NatLabRockies/MODAQ-BB/README.md

# MODAQ Black Box Code and Documentation. 

MODAQ-BB documentation is available here: https://nrel.github.io/MODAQ-BB/

Known Issues:
1. Incremental rebooting approximately every 2 hours 
2. Occasional duplicate satellite messages 

NREL Software Record number: SWR-24-72 “MODAQ BlackBox"
