NatLabRockies/MODAQ-BB/docs/docs/img/CAD_Ant_Shelf_Assemb.png

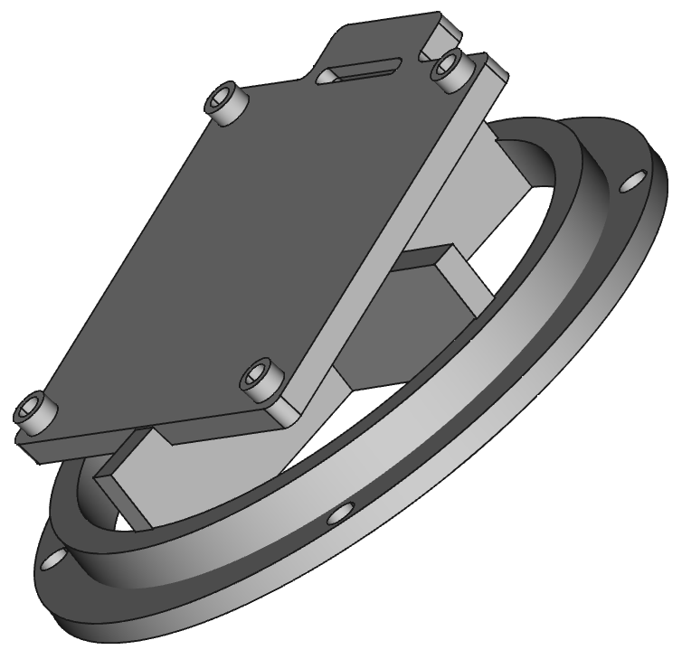
docs/docs/img/CAD_Ant_Shelf_Assemb.png
