NatLabRockies/MODAQ-BB/docs/docs/img/CAD_Complete.png

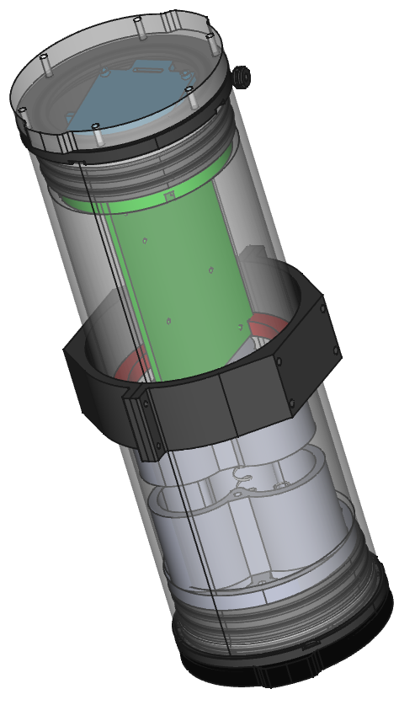
docs/docs/img/CAD_Complete.png
