NatLabRockies/MODAQ-BB/docs/docs/img/CAD_Elect_Shelf_Assemb.png

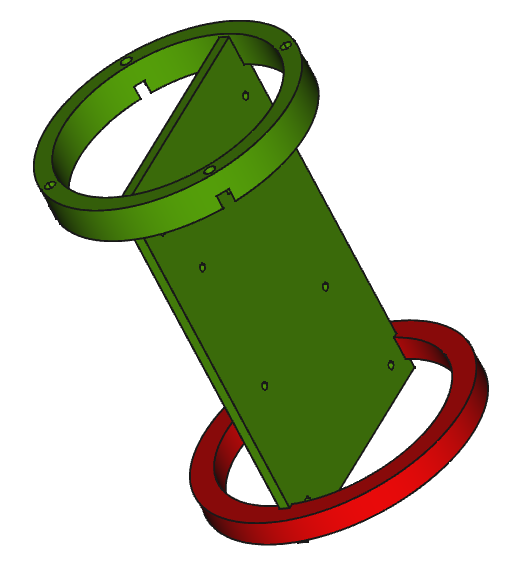
docs/docs/img/CAD_Elect_Shelf_Assemb.png
