NatLabRockies/MODAQ-BB/docs/docs/assets/Electronics_Shelf_Assembly.stl

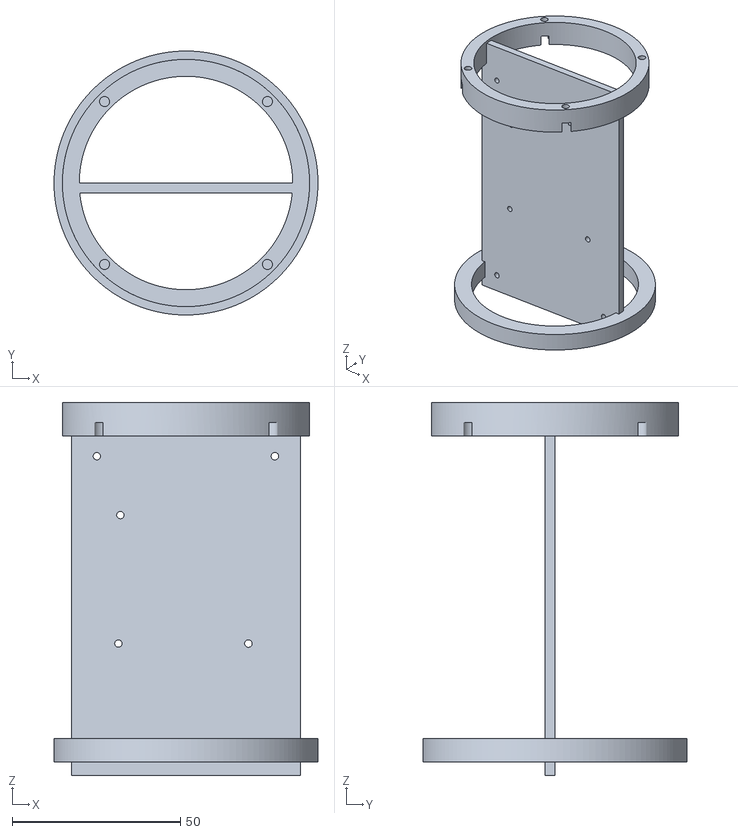
[picture p12: CAD file, 2025-12-03]
docs/docs/assets/Electronics_Shelf_Assembly.stl
78.6 x 78.6 x 111.0
