NatLabRockies/MODAQ-BB/docs/docs/assets/Antenna_Shelf_Assembly.stl

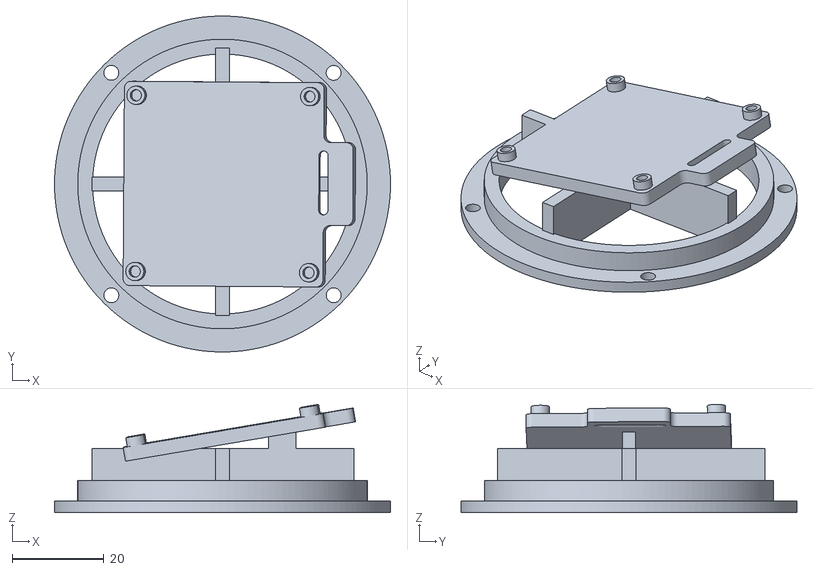
[picture p13: CAD file, 2025-12-03]
docs/docs/assets/Antenna_Shelf_Assembly.stl
73.3 x 73.3 x 23.6
