NatLabRockies/MODAQ-BB/src/LIS3MDL_runtime.h

// Ensure lis3mdl is declared and initialized before using this function
void printOperatingMode() {
  Serial.print("Operation mode set to: ");
  int mode = lis3mdl.getOperationMode();
  switch (mode) {
    case LIS3MDL_CONTINUOUSMODE: Serial.println("Continuous"); break;
    case LIS3MDL_SINGLEMODE: Serial.println("Single mode"); break;
    case LIS3MDL_POWERDOWNMODE: Serial.println("Power-down"); break;
    default: Serial.println("Unknown mode"); break;
  }
}

void printPerformanceMode() {
  Serial.print("Performance mode set to: ");
  switch (lis3mdl.getPerformanceMode()) {
    case LIS3MDL_LOWPOWERMODE: Serial.println("Low"); break;
    case LIS3MDL_MEDIUMMODE: Serial.println("Medium"); break;
    case LIS3MDL_HIGHMODE: Serial.println("High"); break;
    case LIS3MDL_ULTRAHIGHMODE: Serial.println("Ultra-High"); break;
  }
}

void printDataRate() {
  Serial.print("Data rate set to: ");
  switch (lis3mdl.getDataRate()) {
    case LIS3MDL_DATARATE_0_625_HZ: Serial.println("0.625 Hz"); break;
    case LIS3MDL_DATARATE_1_25_HZ: Serial.println("1.25 Hz"); break;
    case LIS3MDL_DATARATE_2_5_HZ: Serial.println("2.5 Hz"); break;
    case LIS3MDL_DATARATE_5_HZ: Serial.println("5 Hz"); break;
    case LIS3MDL_DATARATE_10_HZ: Serial.println("10 Hz"); break;
    case LIS3MDL_DATARATE_20_HZ: Serial.println("20 Hz"); break;
    case LIS3MDL_DATARATE_40_HZ: Serial.println("40 Hz"); break;
    case LIS3MDL_DATARATE_80_HZ: Serial.println("80 Hz"); break;
    case LIS3MDL_DATARATE_155_HZ: Serial.println("155 Hz"); break;
    case LIS3MDL_DATARATE_300_HZ: Serial.println("300 Hz"); break;
    case LIS3MDL_DATARATE_560_HZ: Serial.println("560 Hz"); break;
    case LIS3MDL_DATARATE_1000_HZ: Serial.println("1000 Hz"); break;
  }
}

void printRange() {
  Serial.print("Range set to: ");
  switch (lis3mdl.getRange()) {
    case LIS3MDL_RANGE_4_GAUSS: Serial.println("+-4 gauss"); break;
    case LIS3MDL_RANGE_8_GAUSS: Serial.println("+-8 gauss"); break;
    case LIS3MDL_RANGE_12_GAUSS: Serial.println("+-12 gauss"); break;
    case LIS3MDL_RANGE_16_GAUSS: Serial.println("+-16 gauss"); break;
  }
}

void setInterrupt_LIS3MDL() {
    lis3mdl.setIntThreshold(500);
    lis3mdl.configInterrupt(false, false, true, // enable z axis
                          true, // polarity
                          false, // don't latch
                          true); // enabled!
}
