NatLabRockies/MODAQ-BB/(commit log)

2025-12-03 Deployed d961160 with MkDocs version: 1.6.1
    [Antenna_Shelf_Assembly.stl, Electronics_Shelf_Assembly.stl]
2026-02-20 Switched case setting logic
2026-02-24 Update
    - Changed logger
    - Added disabled interrupts when checking them
    - Switched vtaskDelete to delete current tasks (NULL)
2026-02-26 Added uartSemephore check for log file writer
